GadgetReboot/4017_LED_Scanner/README.md

# 4017_LED_Scanner
8 LEDs scan back and forth like that futuristic black 80's Trans AM
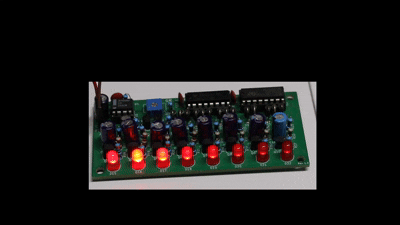
[picture p1: LED_Light.gif]
PCB1
<br><br>
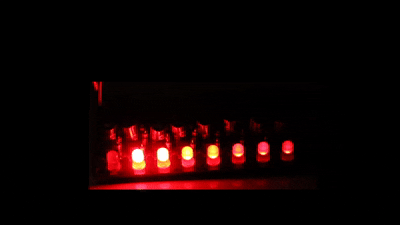
[picture p2: LED_Dark.gif]
PCB2
<br><br><BR><BR>
