GadgetReboot/4017_LED_Scanner/Sch_4017_LED_Scanner.pdf

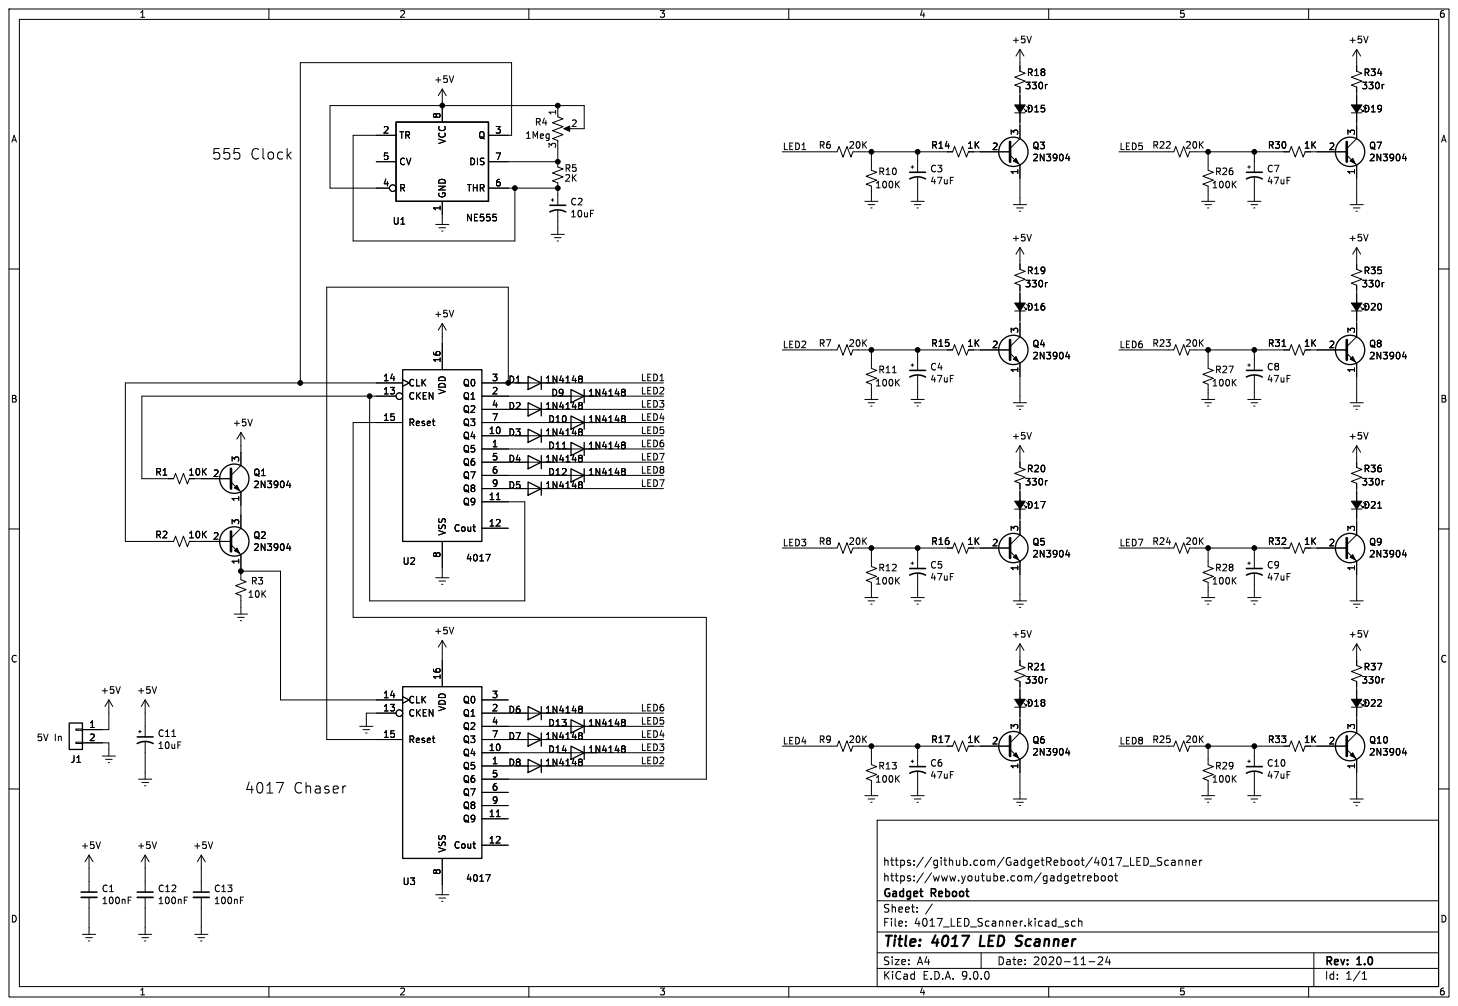
[picture p3: page 1]
