GadgetReboot/4017_LED_Scanner/KiCAD/4017_LED_Scanner.kicad_pcb

## KiCad design KiCAD/4017_LED_Scanner.kicad_pcb (2025-02-28)

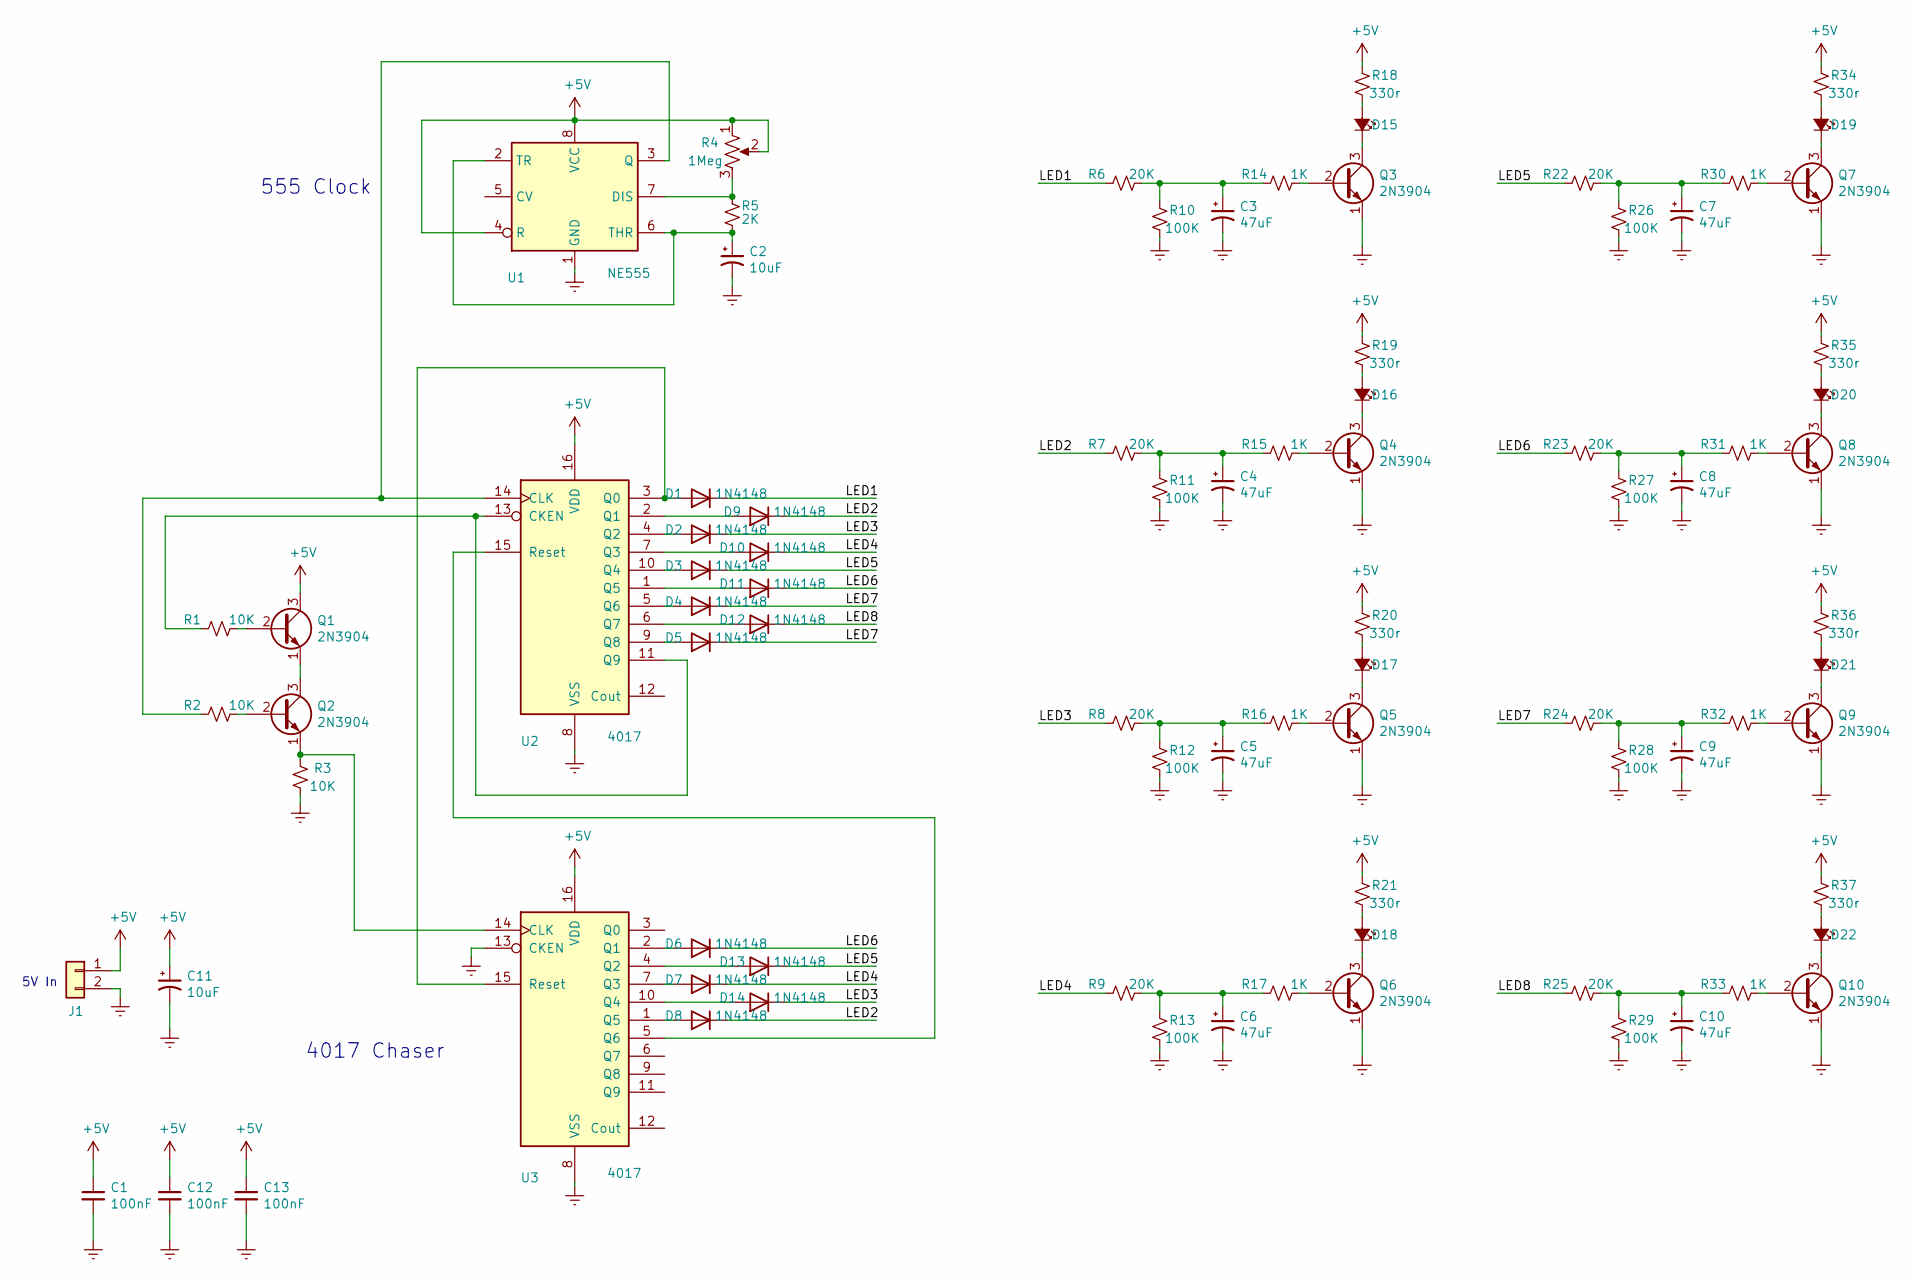
[picture p4: schematic 4017_LED_Scanner.kicad_sch, 4017 LED Scanner]

Parts:
C1, C12, C13: 100nF; C_Disc_D3.0mm_W1.6mm_P2.50mm
C2, C11: 10uF; CP_Radial_D5.0mm_P2.50mm
C3, C4, C5, C6, C7, C8, C9, C10: 47uF; CP_Radial_D5.0mm_P2.50mm
D1, D2, D3, D4, D5, D6, D7, D8, D9, D10, D11, D12, D13, D14: 1N4148; D_DO-35_SOD27_P3.81mm_Vertical_KathodeUp
D15, D16, D17, D18, D19, D20, D21, D22: LED_Small_ALT; LED_D5.0mm
J1: Conn_01x02; PinHeader_1x02_P2.54mm_Vertical
Q1, Q2, Q3, Q4, Q5, Q6, Q7, Q8, Q9, Q10: 2N3904; TO-92L_Inline
R1, R2, R3: 10K; R_Axial_DIN0207_L6.3mm_D2.5mm_P2.54mm_Vertical
R4: 1Meg; Potentiometer_ACP_CA9-H2,5_Horizontal
R5: 2K; R_Axial_DIN0207_L6.3mm_D2.5mm_P2.54mm_Vertical
R6, R7, R8, R9, R22, R23, R24, R25: 20K; R_Axial_DIN0207_L6.3mm_D2.5mm_P2.54mm_Vertical
R10, R11, R12, R13, R26, R27, R28, R29: 100K; R_Axial_DIN0207_L6.3mm_D2.5mm_P2.54mm_Vertical
R14, R15, R16, R17, R30, R31, R32, R33: 1K; R_Axial_DIN0207_L6.3mm_D2.5mm_P2.54mm_Vertical
R18, R19, R20, R21, R34, R35, R36, R37: 330r; R_Axial_DIN0207_L6.3mm_D2.5mm_P2.54mm_Vertical
U1: NE555; DIP-8_W7.62mm
U2, U3: 4017; DIP-16_W7.62mm

Connections:
+5V: C1.1, C11.1, C12.1, C13.1, J1.1, Q1.3 (C), R4.1, R4.2, R18.2, R19.2, R20.2, R21.2, R34.2, R35.2, R36.2, R37.2, U1.4 (R), U1.8 (VCC), U2.16 (VDD), U3.16 (VDD)
/LED1: D1.1 (K), R6.2
/LED2: D8.1 (K), D9.1 (K), R7.2
/LED3: D2.1 (K), D14.1 (K), R8.2
/LED4: D7.1 (K), D10.1 (K), R9.2
/LED5: D3.1 (K), D13.1 (K), R22.2
/LED6: D6.1 (K), D11.1 (K), R23.2
/LED7: D4.1 (K), D5.1 (K), R24.2
/LED8: D12.1 (K), R25.2
GNDREF: C1.2, C2.2, C3.2, C4.2, C5.2, C6.2, C7.2, C8.2, C9.2, C10.2, C11.2, C12.2, C13.2, J1.2, Q3.1 (E), Q4.1 (E), Q5.1 (E), Q6.1 (E), Q7.1 (E), Q8.1 (E), Q9.1 (E), Q10.1 (E), R3.1, R10.1, R11.1, R12.1, R13.1, R26.1, R27.1, R28.1, R29.1, U1.1 (GND), U2.8 (VSS), U3.8 (VSS), U3.13 (CKEN)
unnamed: C2.1, R5.2, U1.2 (TR), U1.6 (THR)
unnamed: C3.1, R6.1, R10.2, R14.2
unnamed: C4.1, R7.1, R11.2, R15.2
unnamed: C5.1, R8.1, R12.2, R16.2
unnamed: C6.1, R9.1, R13.2, R17.2
unnamed: C7.1, R22.1, R26.2, R30.2
unnamed: C8.1, R23.1, R27.2, R31.2
unnamed: C9.1, R24.1, R28.2, R32.2
unnamed: C10.1, R25.1, R29.2, R33.2
unnamed: D1.2 (A), U2.3 (Q0), U3.15 (Reset)
unnamed: D2.2 (A), U2.4 (Q2)
unnamed: D3.2 (A), U2.10 (Q4)
unnamed: D4.2 (A), U2.5 (Q6)
unnamed: D5.2 (A), U2.9 (Q8)
unnamed: D6.2 (A), U3.2 (Q1)
unnamed: D7.2 (A), U3.7 (Q3)
unnamed: D8.2 (A), U3.1 (Q5)
unnamed: D9.2 (A), U2.2 (Q1)
unnamed: D10.2 (A), U2.7 (Q3)
unnamed: D11.2 (A), U2.1 (Q5)
unnamed: D12.2 (A), U2.6 (Q7)
unnamed: D13.2 (A), U3.4 (Q2)
unnamed: D14.2 (A), U3.10 (Q4)
unnamed: D15.1 (K), Q3.3 (C)
unnamed: D15.2 (A), R18.1
unnamed: D16.1 (K), Q4.3 (C)
unnamed: D16.2 (A), R19.1
unnamed: D17.1 (K), Q5.3 (C)
unnamed: D17.2 (A), R20.1
unnamed: D18.1 (K), Q6.3 (C)
unnamed: D18.2 (A), R21.1
unnamed: D19.1 (K), Q7.3 (C)
unnamed: D19.2 (A), R34.1
unnamed: D20.1 (K), Q8.3 (C)
unnamed: D20.2 (A), R35.1
unnamed: D21.1 (K), Q9.3 (C)
unnamed: D21.2 (A), R36.1
unnamed: D22.1 (K), Q10.3 (C)
unnamed: D22.2 (A), R37.1
unnamed: Q1.1 (E), Q2.3 (C)
unnamed: Q1.2 (B), R1.1
unnamed: Q2.1 (E), R3.2, U3.14 (CLK)
unnamed: Q2.2 (B), R2.1
unnamed: Q3.2 (B), R14.1
unnamed: Q4.2 (B), R15.1
unnamed: Q5.2 (B), R16.1
unnamed: Q6.2 (B), R17.1
unnamed: Q7.2 (B), R30.1
unnamed: Q8.2 (B), R31.1
unnamed: Q9.2 (B), R32.1
unnamed: Q10.2 (B), R33.1
unnamed: R1.2, U2.11 (Q9), U2.13 (CKEN)
unnamed: R2.2, U1.3 (Q), U2.14 (CLK)
unnamed: R4.3, R5.1, U1.7 (DIS)
unnamed: U2.15 (Reset), U3.5 (Q6)

Notes on the sheet:
5V In
555 Clock
4017 Chaser

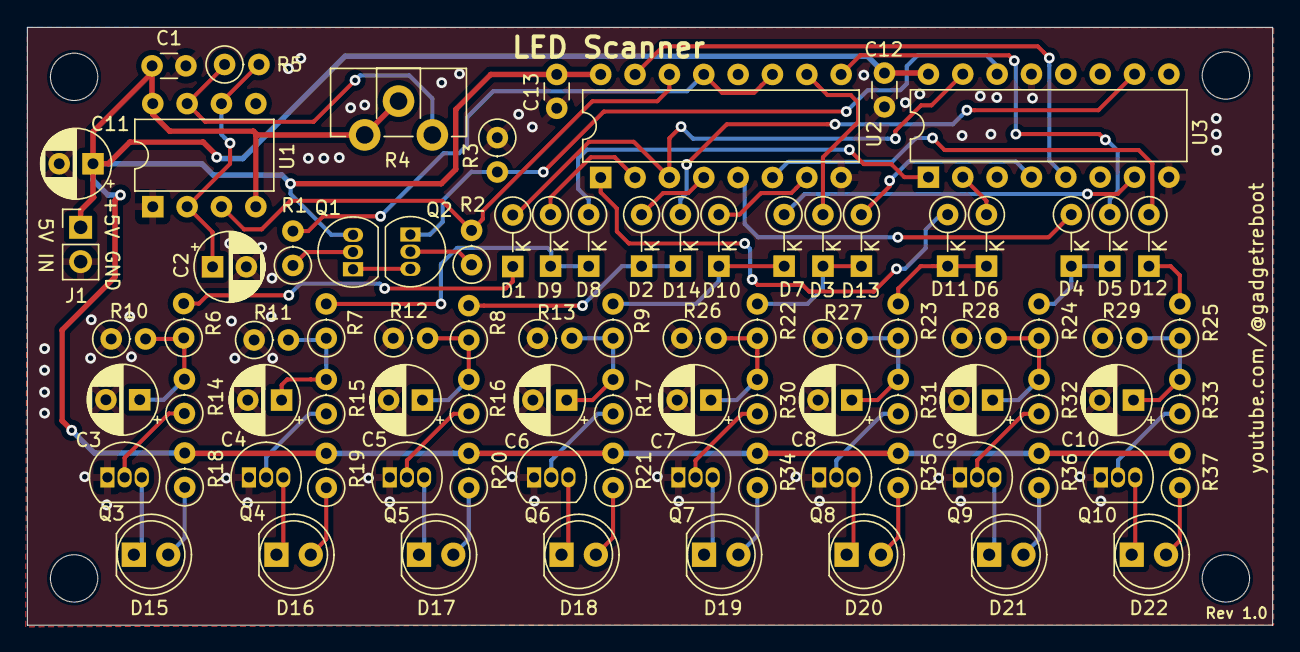
[picture p5: board 4017_LED_Scanner.kicad_pcb from above]

Board: 2 copper layers, 92.1 x 44.2 mm, 86 parts (0 on the bottom side), 65 nets.
